stefantquach/keyboard_eval/keyboard_eval/pdf_sch/keyboard_eval.pdf

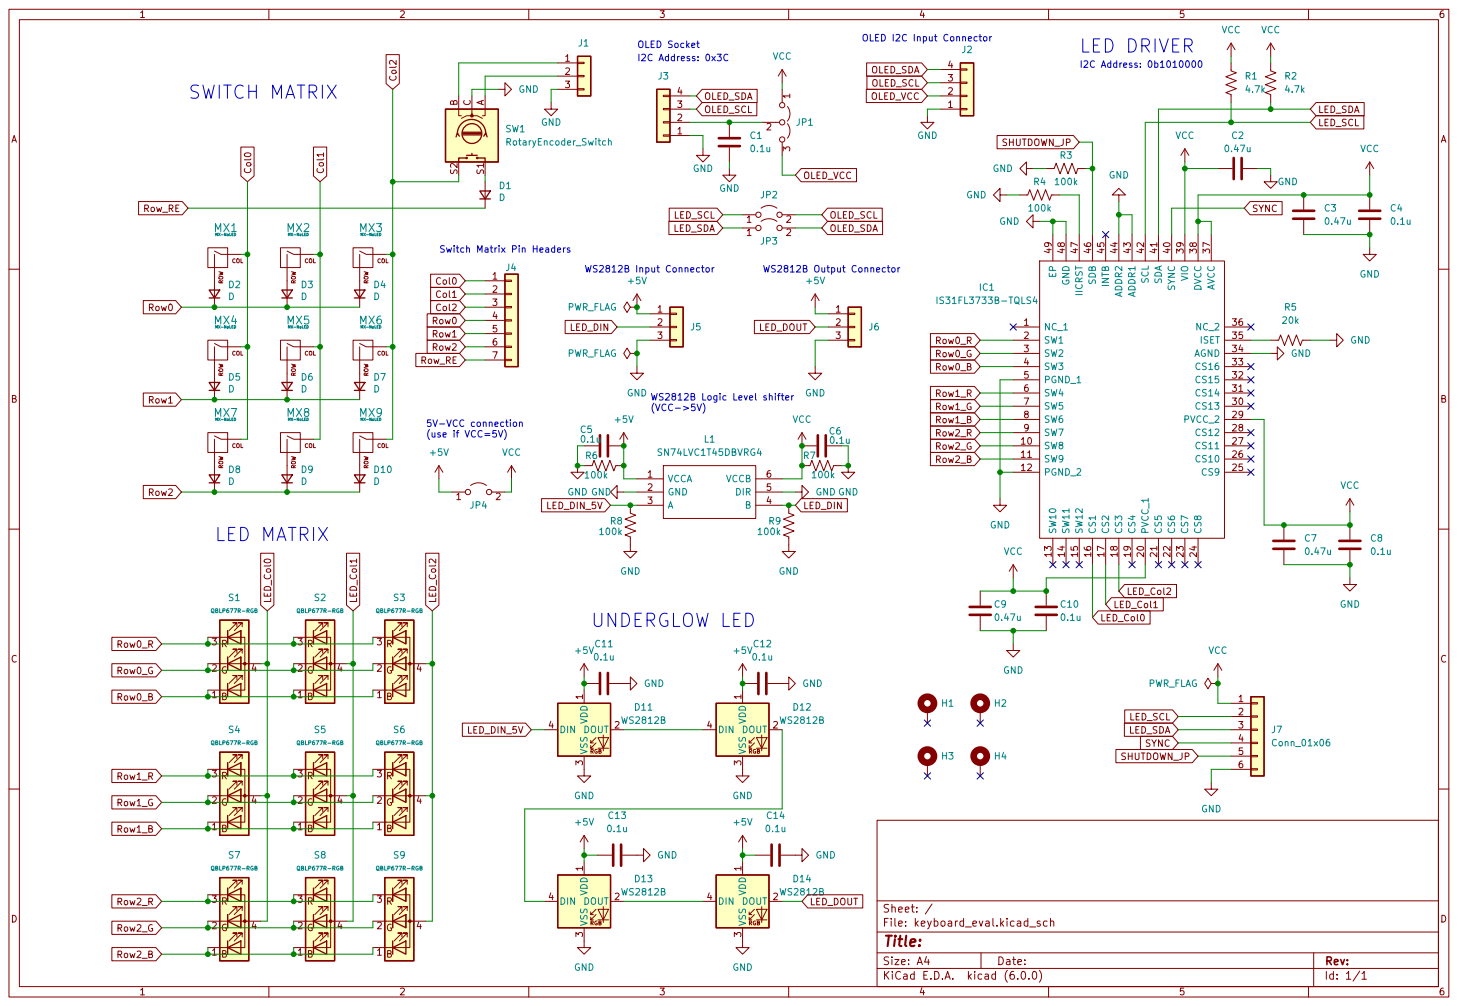
[picture p1: page 1]

COL ROW MX8 MX-NoLED BG

COL ROW MX6 MX-NoLED D6 D
