stefantquach/keyboard_eval/keyboard_eval/keyboard_eval.kicad_pcb

## KiCad design keyboard_eval/keyboard_eval.kicad_pcb (2023-01-22)

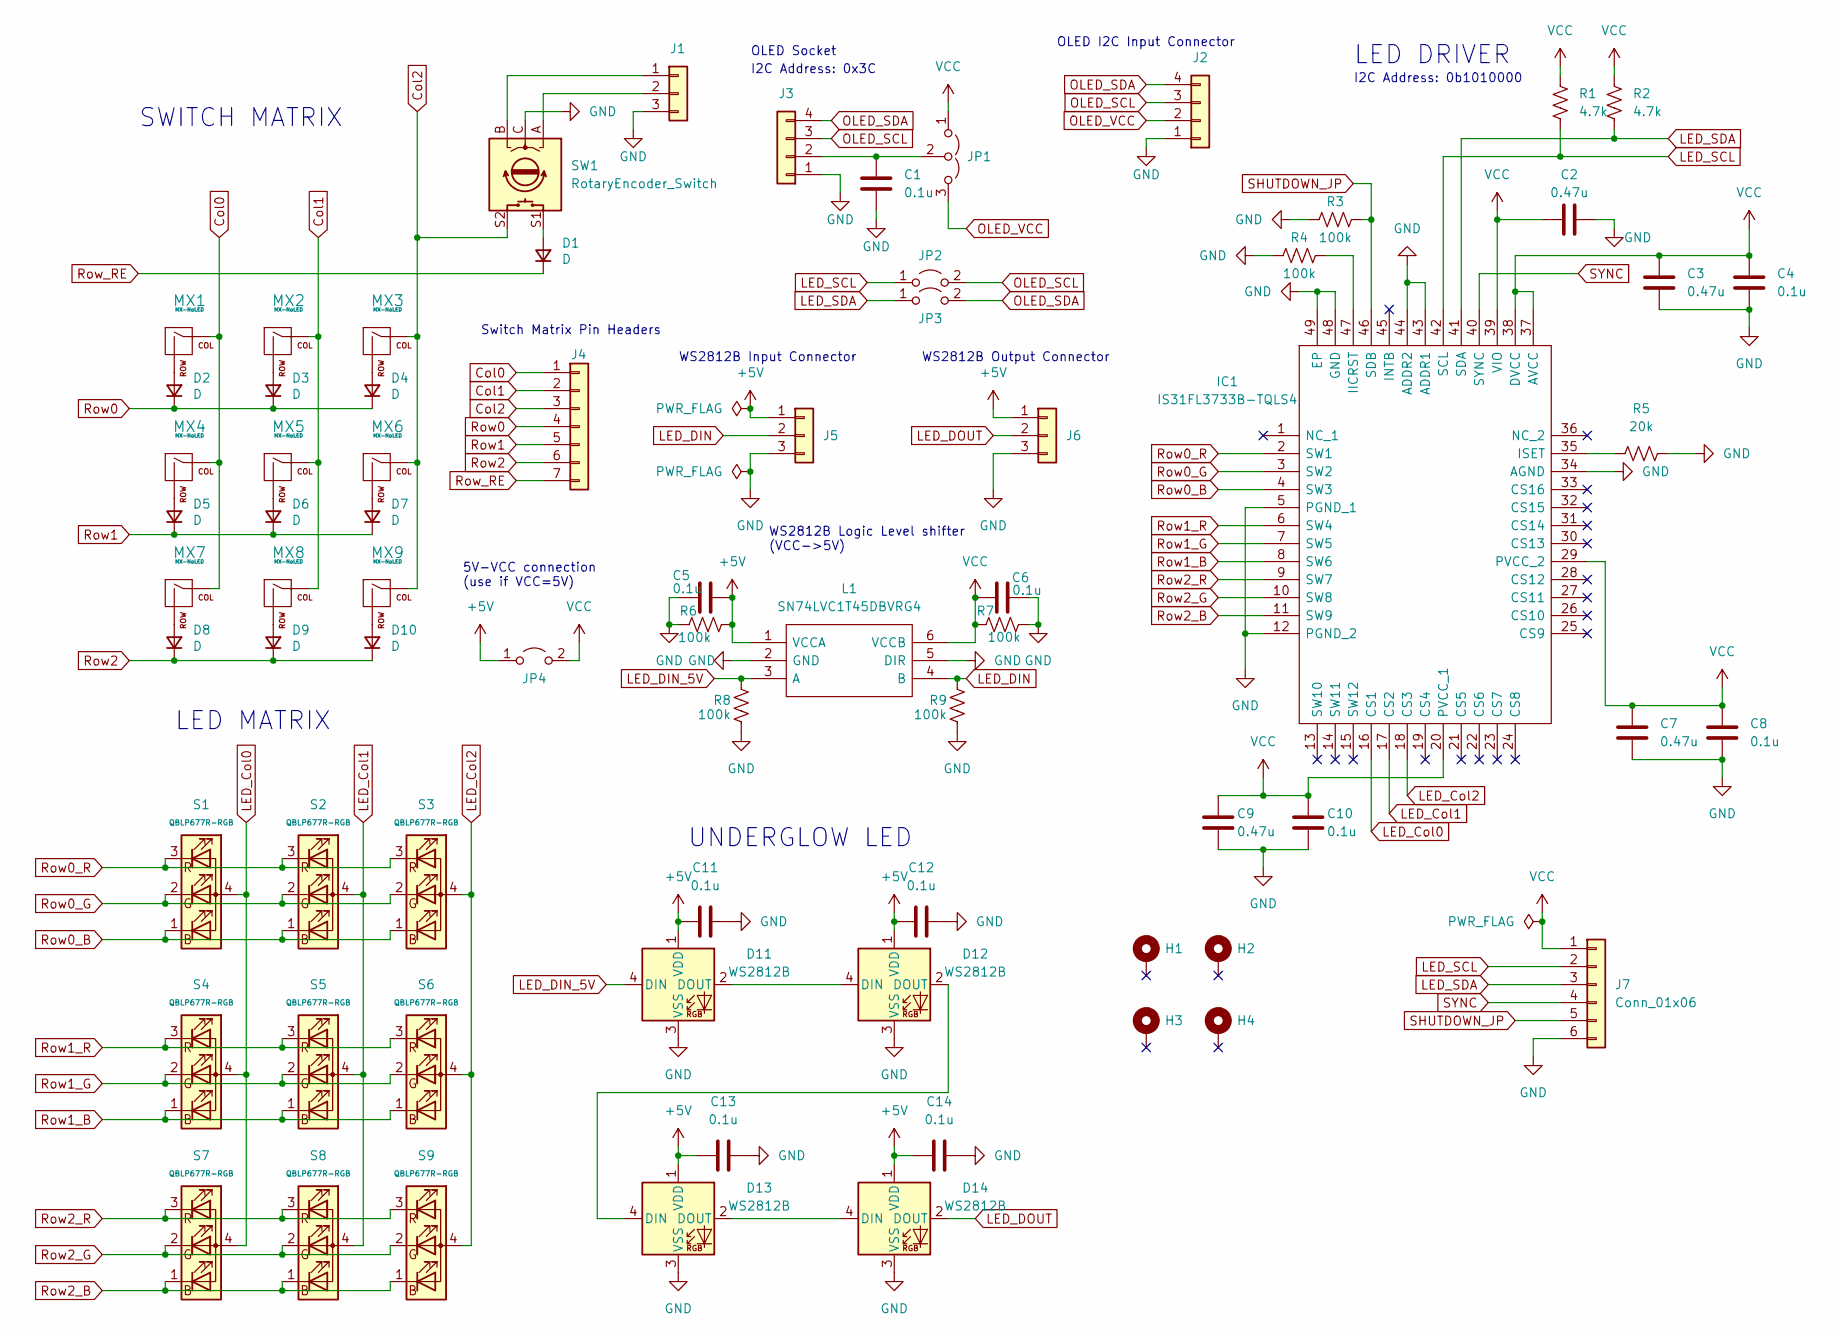
[picture p2: schematic keyboard_eval.kicad_sch]

Parts:
C1, C4, C5, C6, C8, C10, C11, C12, C13, C14: 0.1u; C_0603_1608Metric_Pad1.08x0.95mm_HandSolder
C2, C3, C7, C9: 0.47u; C_0603_1608Metric_Pad1.08x0.95mm_HandSolder
D1, D2, D3, D4, D5, D6, D7, D8, D9, D10: D; D_SOD-123-Pretty
D11, D12, D13, D14: WS2812B; LED_WS2812B_PLCC4_5.0x5.0mm_P3.2mm
H1, H2, H3, H4: MountingHole_Pad; MountingHole_2.2mm_M2_DIN965_Pad_TopBottom
IC1: IS31FL3733B-TQLS4; QFP50P900X900X120-49N; Manufacturer_Part_Number IS31FL3733B-TQLS4; Mouser Part Number 870-IS313733B-TQLS4
J1, J5, J6: Conn_01x03; PinHeader_1x03_P2.54mm_Vertical
J2, J3: Conn_01x04; PinHeader_1x04_P2.54mm_Vertical
J4: Conn_01x07; PinHeader_1x07_P2.54mm_Vertical
J7: Conn_01x06; PinHeader_1x06_P2.54mm_Vertical
JP1: Jumper_3_Open; SolderJumper-3_P1.3mm_Open_RoundedPad1.0x1.5mm
JP2, JP3, JP4: Jumper_2_Open; SolderJumper-2_P1.3mm_Open_RoundedPad1.0x1.5mm
L1: SN74LVC1T45DBVRG4; SOT95P280X145-6N; Manufacturer_Part_Number SN74LVC1T45DBVRG4; Mouser Part Number 595-74LVC1T45DBVRG4
MX1, MX2, MX3, MX4, MX5, MX6, MX7, MX8, MX9: MX-NoLED; MX-Hotswap-1U
R1, R2: 4.7k; R_0603_1608Metric_Pad0.98x0.95mm_HandSolder
R3, R4, R6, R7, R8, R9: 100k; R_0603_1608Metric_Pad0.98x0.95mm_HandSolder
R5: 20k; R_0603_1608Metric_Pad0.98x0.95mm_HandSolder
S1, S2, S3, S4, S5, S6, S7, S8, S9: QBLP677R-RGB; QBLP677R-RGB-square_cutout
SW1: RotaryEncoder_Switch; RotaryEncoder_Alps_EC11E-Switch-Vertical-EDIT

Connections:
+5V: C5.2, C11.1, C12.1, C13.1, C14.1, D11.1 (VDD), D12.1 (VDD), D13.1 (VDD), D14.1 (VDD), J5.1, J6.1, JP4.1 (A), L1.1 (VCCA), R6.1
Col0: J4.1, MX1.1 (COL), MX4.1 (COL), MX7.1 (COL)
Col1: J4.2, MX2.1 (COL), MX5.1 (COL), MX8.1 (COL)
Col2: J4.3, MX3.1 (COL), MX6.1 (COL), MX9.1 (COL), SW1.S2
GND: C1.2, C2.2, C3.2, C4.2, C5.1, C6.2, C7.2, C8.2, C9.2, C10.2, C11.2, C12.2, C13.2, C14.2, D11.3 (VSS), D12.3 (VSS), D13.3 (VSS), D14.3 (VSS), IC1.5 (PGND_1), IC1.12 (PGND_2), IC1.34 (AGND), IC1.43 (ADDR1), IC1.44 (ADDR2), IC1.48 (GND), IC1.49 (EP), J1.3, J2.1, J3.1, J5.3, J6.3, J7.6, L1.2 (GND), L1.5 (DIR), R3.1, R4.1, R5.2, R6.2, R7.1, R8.1, R9.1, SW1.C
LED_Col0: IC1.16 (CS1), S1.4 (A), S4.4 (A), S7.4 (A)
LED_Col1: IC1.17 (CS2), S2.4 (A), S5.4 (A), S8.4 (A)
LED_Col2: IC1.18 (CS3), S3.4 (A), S6.4 (A), S9.4 (A)
LED_DIN: J5.2, L1.4 (B), R9.2
LED_DIN_5V: D11.4 (DIN), L1.3 (A), R8.2
LED_DOUT: D14.2 (DOUT), J6.2
LED_SCL: IC1.42 (SCL), J7.2, JP2.1 (A), R1.2
LED_SDA: IC1.41 (SDA), J7.3, JP3.1 (A), R2.2
unnamed: C1.1, J3.2, JP1.2 (C)
unnamed: D1.2 (A), SW1.S1
unnamed: D2.2 (A), MX1.2 (ROW)
unnamed: D3.2 (A), MX2.2 (ROW)
unnamed: D4.2 (A), MX3.2 (ROW)
unnamed: D5.2 (A), MX4.2 (ROW)
unnamed: D6.2 (A), MX5.2 (ROW)
unnamed: D7.2 (A), MX6.2 (ROW)
unnamed: D8.2 (A), MX7.2 (ROW)
unnamed: D9.2 (A), MX8.2 (ROW)
unnamed: D10.2 (A), MX9.2 (ROW)
unnamed: D11.2 (DOUT), D12.4 (DIN)
unnamed: D12.2 (DOUT), D13.4 (DIN)
unnamed: D13.2 (DOUT), D14.4 (DIN)
unnamed: IC1.35 (ISET), R5.1
unnamed: IC1.47 (IICRST), R4.2
unnamed: J1.1, SW1.B
unnamed: J1.2, SW1.A
OLED_SCL: J2.3, J3.3, JP2.2 (B)
OLED_SDA: J2.4, J3.4, JP3.2 (B)
OLED_VCC: J2.2, JP1.3 (B)
Row0: D2.1 (K), D3.1 (K), D4.1 (K), J4.4
Row0_B: IC1.4 (SW3), S1.1 (BK), S2.1 (BK), S3.1 (BK)
Row0_G: IC1.3 (SW2), S1.2 (GK), S2.2 (GK), S3.2 (GK)
Row0_R: IC1.2 (SW1), S1.3 (RK), S2.3 (RK), S3.3 (RK)
Row1: D5.1 (K), D6.1 (K), D7.1 (K), J4.5
Row1_B: IC1.8 (SW6), S4.1 (BK), S5.1 (BK), S6.1 (BK)
Row1_G: IC1.7 (SW5), S4.2 (GK), S5.2 (GK), S6.2 (GK)
Row1_R: IC1.6 (SW4), S4.3 (RK), S5.3 (RK), S6.3 (RK)
Row2: D8.1 (K), D9.1 (K), D10.1 (K), J4.6
Row2_B: IC1.11 (SW9), S7.1 (BK), S8.1 (BK), S9.1 (BK)
Row2_G: IC1.10 (SW8), S7.2 (GK), S8.2 (GK), S9.2 (GK)
Row2_R: IC1.9 (SW7), S7.3 (RK), S8.3 (RK), S9.3 (RK)
Row_RE: D1.1 (K), J4.7
SHUTDOWN_JP: IC1.46 (SDB), J7.5, R3.2
SYNC: IC1.40 (SYNC), J7.4
VCC: C2.1, C3.1, C4.1, C6.1, C7.1, C8.1, C9.1, C10.1, IC1.20 (PVCC_1), IC1.29 (PVCC_2), IC1.37 (AVCC), IC1.38 (DVCC), IC1.39 (VIO), J7.1, JP1.1 (A), JP4.2 (B), L1.6 (VCCB), R1.1, R2.1, R7.2

Notes on the sheet:
OLED I2C Input Connector
I2C Address: 0x3C
UNDERGLOW LED
LED DRIVER
5V-VCC connection (use if VCC=5V)
WS2812B Output Connector
I2C Address: 0b1010000
WS2812B Logic Level shifter (VCC->5V)
SWITCH MATRIX
WS2812B Input Connector
OLED Socket
LED MATRIX
Switch Matrix Pin Headers

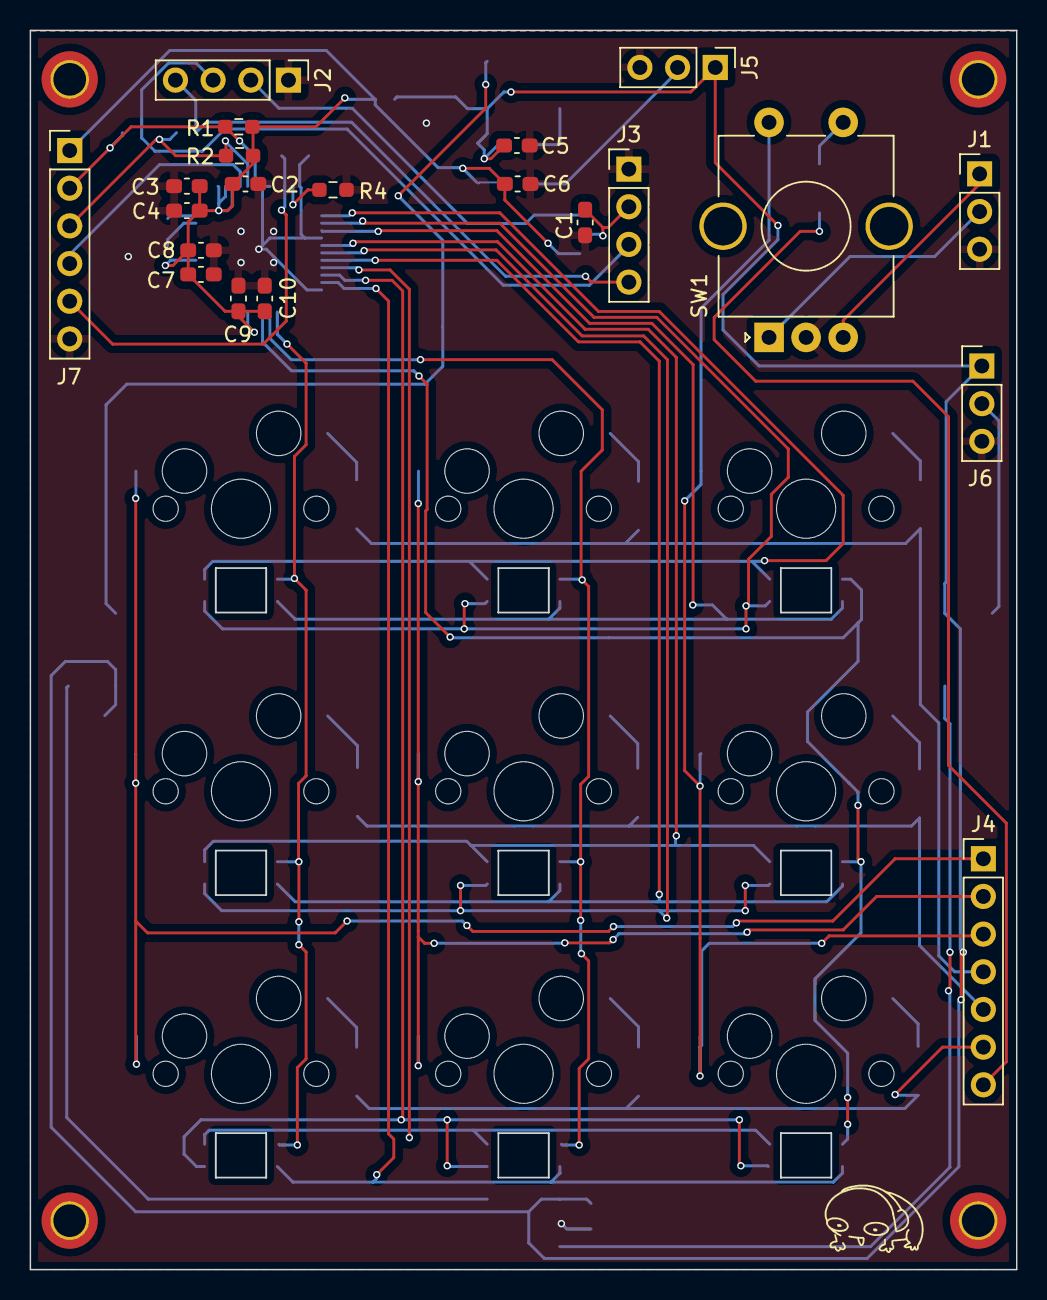
[picture p3: board keyboard_eval.kicad_pcb from above]

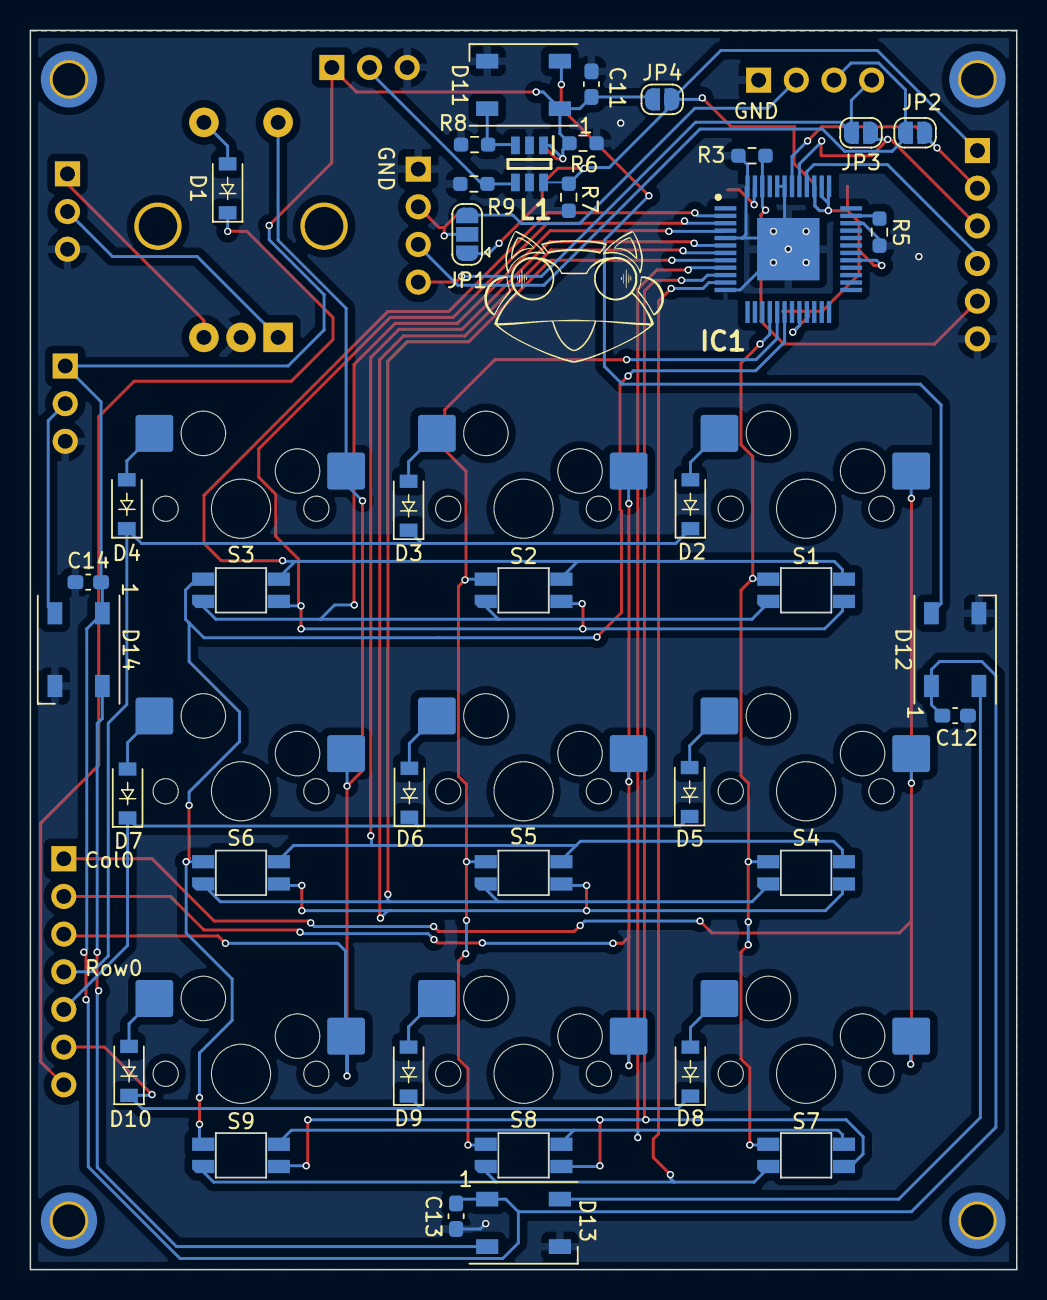
[picture p4: board keyboard_eval.kicad_pcb from below]

Board: 2 copper layers, 66.5 x 83.5 mm, 73 parts (39 on the bottom side), 50 nets.
