stefantquach/keyboard_eval/firmware/config.h

// Copyright 2023 Stefan Quach (@Stefan Quach)
// SPDX-License-Identifier: GPL-2.0-or-later

#pragma once

/*
 * Feature disable options
 *  These options are also useful to firmware size reduction.
 */

/* disable debug print */
//#define NO_DEBUG

/* disable print */
//#define NO_PRINT

/* disable action features */
//#define NO_ACTION_LAYER
//#define NO_ACTION_TAPPING
//#define NO_ACTION_ONESHOT

/*
 * Keyboard Matrix Assignments
 *
 * Change this to how you wired your keyboard
 * COLS: AVR pins used for columns, left to right
 * ROWS: AVR pins used for rows, top to bottom
 * DIODE_DIRECTION: COL2ROW = COL = Anode (+), ROW = Cathode (-, marked on diode)
 *                  ROW2COL = ROW = Anode (+), COL = Cathode (-, marked on diode)
 *
 */
/* key matrix size */
#define MATRIX_ROWS 4
#define MATRIX_COLS 3

#define MATRIX_ROW_PINS { F5, B1, F7, F6 } 
#define MATRIX_COL_PINS { B6, B2, B3 }

/* COL2ROW, ROW2COL */
#define DIODE_DIRECTION COL2ROW

/* Debounce reduces chatter (unintended double-presses) - set 0 if debouncing is not needed */
#define DEBOUNCE 5

/* 
 * RGB Matrix 
 * 
 * This is the per-key RGB lighting driven by the IS31FL3733(B)
 * 
 * */
#define DRIVER_COUNT 1
#define DRIVER_ADDR_1 0b1010000

#define RGB_MATRIX_LED_COUNT 27 // 9 LEDS * 3 RGB

#define ISSI_PWM_FREQUENCY 0
#define ISSI_GLOBALCURRENT 0xFF

#define RGB_MATRIX_DEFAULT_VAL 80
#define RGB_MATRIX_FRAMEBUFFER_EFFECTS
#define RGB_MATRIX_KEYPRESSES
#define RGB_DISABLE_WHEN_USB_SUSPENDED  // turn off effects when suspended
#define RGB_MATRIX_DEFAULT_MODE RGB_MATRIX_HUE_WAVE

#define ENABLE_RGB_MATRIX_ALPHAS_MODS
#define ENABLE_RGB_MATRIX_GRADIENT_UP_DOWN
#define ENABLE_RGB_MATRIX_GRADIENT_LEFT_RIGHT
#define ENABLE_RGB_MATRIX_BREATHING
// #define ENABLE_RGB_MATRIX_BAND_SAT
// #define ENABLE_RGB_MATRIX_BAND_VAL
// #define ENABLE_RGB_MATRIX_BAND_PINWHEEL_SAT
// #define ENABLE_RGB_MATRIX_BAND_PINWHEEL_VAL
// #define ENABLE_RGB_MATRIX_BAND_SPIRAL_SAT
// #define ENABLE_RGB_MATRIX_BAND_SPIRAL_VAL
// #define ENABLE_RGB_MATRIX_CYCLE_ALL
// #define ENABLE_RGB_MATRIX_CYCLE_LEFT_RIGHT
// #define ENABLE_RGB_MATRIX_CYCLE_UP_DOWN
// #define ENABLE_RGB_MATRIX_RAINBOW_MOVING_CHEVRON
// #define ENABLE_RGB_MATRIX_CYCLE_OUT_IN
// #define ENABLE_RGB_MATRIX_CYCLE_OUT_IN_DUAL
// #define ENABLE_RGB_MATRIX_CYCLE_PINWHEEL
// #define ENABLE_RGB_MATRIX_CYCLE_SPIRAL
// #define ENABLE_RGB_MATRIX_DUAL_BEACON
// #define ENABLE_RGB_MATRIX_RAINBOW_BEACON
// #define ENABLE_RGB_MATRIX_RAINBOW_PINWHEELS
// #define ENABLE_RGB_MATRIX_RAINDROPS
// #define ENABLE_RGB_MATRIX_JELLYBEAN_RAINDROPS
// #define ENABLE_RGB_MATRIX_HUE_BREATHING
// #define ENABLE_RGB_MATRIX_HUE_PENDULUM
#define ENABLE_RGB_MATRIX_HUE_WAVE
// #define ENABLE_RGB_MATRIX_FRACTAL
// #define ENABLE_RGB_MATRIX_PIXEL_RAIN

#define ENABLE_RGB_MATRIX_TYPING_HEATMAP
#define ENABLE_RGB_MATRIX_DIGITAL_RAIN

#define ENABLE_RGB_MATRIX_SOLID_REACTIVE_SIMPLE
// #define ENABLE_RGB_MATRIX_SOLID_REACTIVE
// #define ENABLE_RGB_MATRIX_SOLID_REACTIVE_WIDE
// #define ENABLE_RGB_MATRIX_SOLID_REACTIVE_MULTIWIDE
// #define ENABLE_RGB_MATRIX_SOLID_REACTIVE_CROSS
// #define ENABLE_RGB_MATRIX_SOLID_REACTIVE_MULTICROSS
// #define ENABLE_RGB_MATRIX_SOLID_REACTIVE_NEXUS
// #define ENABLE_RGB_MATRIX_SOLID_REACTIVE_MULTINEXUS
#define ENABLE_RGB_MATRIX_SPLASH
// #define ENABLE_RGB_MATRIX_MULTISPLASH
// #define ENABLE_RGB_MATRIX_SOLID_SPLASH
// #define ENABLE_RGB_MATRIX_SOLID_MULTISPLASH


/* 
 * RGB Lighting
 * 
 * This is the underglow lighting driven by ws2812B addressable LEDs
 * 
 */
#define RGB_DI_PIN E6
#define RGBLED_NUM 4
#define RGBLIGHT_LED_MAP { 0, 1, 2, 3 }

/* 
 * Encoder configuration
 * 
 */
#define ENCODERS_PAD_A { B4 }
#define ENCODERS_PAD_B { B5 }

/* 
 * OLED configuration
 * 
 */
#define OLED_DISPLAY_ADDRESS 0x3C
#define OLED_BRIGHTNESS 128
#define OLED_IC OLED_IC_SSD1306

#define OLED_DISPLAY_WIDTH 128
#define OLED_DISPLAY_HEIGHT 32
