stefantquach/keyboard_eval/firmware/keymaps/default/keymap.c

#include QMK_KEYBOARD_H

enum my_keycodes {
    WPM = SAFE_RANGE,
};

#define _BASE 0
#define _HUE 1
#define _VAL 2
#define _MOD 3
const uint16_t PROGMEM keymaps[][MATRIX_ROWS][MATRIX_COLS] = {
    /*
     * ┌───┬───┬───┐
     * │ A │ B │ C │
     * ├───┼───┼───┤
     * │ D │ E │ F │
     * ├───┼───┼───┤
     * │ G │ H │ I │
     * └───┴───┴───┘
     */
    [_BASE] = LAYOUT(
                          KC_MPLY, \
        KC_A,    KC_B,    KC_C, \
        KC_D,    KC_E,    KC_F, \
        MO(_HUE),  MO(_VAL),  MO(_MOD)  
    ),

    [_HUE] = LAYOUT(
                                 _______ , \
        _______ ,    _______ ,    _______ , \
        _______ ,    _______ ,    _______ , \
        MO(_HUE),  MO(_VAL),  MO(_MOD)  
    ),

    [_VAL] = LAYOUT(
                        _______ , \
    _______ ,    _______ ,    _______ , \
    _______ ,    _______ ,    _______ , \
    MO(_HUE),  MO(_VAL),  MO(_MOD)  
    ),

    [_MOD] = LAYOUT(
                            RGB_TOG , \
    _______ ,    _______ ,    _______ , \
    _______ ,    _______ ,    _______ , \
    MO(_HUE),  MO(_VAL),  MO(_MOD)  
    ),
};


/* WPM toggle key bongocat hehe */
bool wpm = false;
bool process_record_user(uint16_t keycode, keyrecord_t *record) {
  switch (keycode) {
    case WPM:
        if (record->event.pressed) {
            wpm = !wpm;
        }
        return false;
    default:
        return true;
  }
}
/*layer switcher */
layer_state_t layer_state_set_user(layer_state_t state) {
    state = update_tri_layer_state(state, _HUE, _VAL, _MOD);
    return state;
}

#if defined(ENCODER_MAP_ENABLE)
const uint16_t PROGMEM encoder_map[][NUM_ENCODERS][2] = {
    [_BASE] = { ENCODER_CCW_CW(KC_VOLU, KC_VOLD) },
    [_HUE] =  { ENCODER_CCW_CW(RGB_HUD, RGB_HUI) },
    [_VAL] =  { ENCODER_CCW_CW(RGB_VAD, RGB_VAI) },
    [_MOD] =  { ENCODER_CCW_CW(RGB_RMOD, RGB_MOD) },
};
#endif


#ifdef OLED_ENABLE
#define IDLE_FRAMES 5
#define IDLE_SPEED 20 // below this wpm value your animation will idle
#define TAP_FRAMES 2
#define TAP_SPEED 40 // above this wpm value typing animation to trigger
#define ANIM_FRAME_DURATION 200 // how long each frame lasts in ms
#define ANIM_SIZE 636 // number of bytes in array

uint32_t anim_timer         = 0;
uint32_t anim_sleep         = 0;
uint8_t  current_idle_frame = 0;
uint8_t current_tap_frame = 0;

uint16_t startup_timer = 0;

oled_rotation_t oled_init_user(oled_rotation_t rotation) {
    startup_timer = timer_read();
    return rotation;
}
static void render_logo(void) {
    // static const char PROGMEM raw_logo[] = {
    //     0,  8,  0,192,194,192,192, 60, 60, 44, 60,188, 60, 60, 60, 60, 44, 61, 60,192,192,192,208,  1,  0,252,252,180,252, 60, 60, 44, 60,252,253,252,252, 60, 60, 44, 60,244,220,252,252,  0,  0, 16,  0,  0,  0,192,192, 65,192, 60, 60, 52, 60,192,193,192,192, 16,  0,  0,144,  4,  0,252,125,244, 60, 60, 60, 60, 61,252,252,244,252, 60, 60, 60, 61,248,108,252,  0,  0, 61, 60,188, 60, 52,252,252,220,252, 61, 60, 60, 52,  0,  0,192,210, 64,192, 60, 60, 44, 61, 60, 60, 60, 61, 52, 60, 60, 60,192,192, 64,196,  0,  4,  0,
    //     0, 16,  0, 61, 63, 55, 63,192, 64,192,196,192,192,192,200,192,196,192,192,  3,  3,  2, 11,  0,  0, 35,  3,  3,  3,  0, 64,  2,  0,255,255,253,247,  0,  0,  0, 32,  1,  0,  1, 65,  8,  0,189,244,252,236,  3,130,  3,  1,  0, 68,  0,  0,  3, 34,131,  3,252,252,236,252,  0, 32, 17,  1,  1,  0,  0, 32,  0,  2,255,255,127,247,  0,  1,  0,  8,  1,  1,  1,  0,  0,  0, 16,  0, 64,  0,255,191,255,251,  0,129,  0,  2, 32,  0,255,255,239,255,  0,  0,  2,  0,  0,  0,  8, 64,  0,  1,  0,  0,  3, 35,  3,  3,  0,  8,  0,
    //     1, 16,  0,192, 64,194,192,  3, 67,  3,  3,  9,  3,  3,  3,  3,  2, 83,  3,252,252,188,244,  0,  2, 32,  0,  0,  2,  0,144,  0,  0,255,255,237,255,  0, 16,  0,  0,  0, 64,  2,  0,128,  0,255,123,255,255, 60, 52, 60, 60, 60, 60, 60, 60, 44, 60, 56, 60,239,255,126,255,  0,  2, 32,  0,  0, 34,  0,  0, 16,  0,255,255,255,223,  0,  0,  4,  0,  0,  0, 33,  0,  0, 17,  0,  0,  0,  0,255,255,239,255,  0,128,  0,  0, 72,  0,255,253,247,255,  0,  0,  1,  0,144,  0,  4,  0, 32,  0,  0,  2,192,192,192,200,  0, 16,  0,
    //     64,  4,  0,  3,  7,  3,  3, 60, 60, 52,188, 60, 61, 60, 60, 60, 60, 44, 60, 67,  3,  3,  3,  0,  0, 64,  0,  0,  4,  0,  0, 16,  0, 47, 63, 62, 63,  0,  0,132,  0,  0,  0,  0,128,  8,  0,255,255,111,127,  0,  0,  0,  2,128,  0,  0,  0, 64,  4,  0,128,127,127,107,127,  0, 32,  0,  0,  0, 66,  0,  0,  0,136, 55, 63, 61, 63,  0,  0,  0,  2,  0, 64,  0,136,  0,  0, 60, 44,189, 60, 63, 63, 63, 59, 60, 60,172, 60,  0, 64,  3,  2,  3,131, 60, 44, 60, 60, 60, 60,188, 60, 56, 44, 60, 60,  3,  3,131,  2,  0, 32,  2,
    // };
    // oled_write_raw_P(raw_logo, sizeof(raw_logo));
    static const char PROGMEM qmk_logo[] = {
        0x80, 0x81, 0x82, 0x83, 0x84, 0x85, 0x86, 0x87, 0x88, 0x89, 0x8A, 0x8B, 0x8C, 0x8D, 0x8E, 0x8F, 0x90, 0x91, 0x92, 0x93, 0x94,
        0xA0, 0xA1, 0xA2, 0xA3, 0xA4, 0xA5, 0xA6, 0xA7, 0xA8, 0xA9, 0xAA, 0xAB, 0xAC, 0xAD, 0xAE, 0xAF, 0xB0, 0xB1, 0xB2, 0xB3, 0xB4,
        0xC0, 0xC1, 0xC2, 0xC3, 0xC4, 0xC5, 0xC6, 0xC7, 0xC8, 0xC9, 0xCA, 0xCB, 0xCC, 0xCD, 0xCE, 0xCF, 0xD0, 0xD1, 0xD2, 0xD3, 0xD4, 0x00
    };

    oled_write_P(qmk_logo, false);
}
/* Shows the name of the current layer and locks for the host (CAPS etc.) */
// static void render_layer(void) {
//     led_t led_state = host_keyboard_led_state();
//     // clang-format off
//     static const char PROGMEM logo[][3][7] = {
//         {{0x97, 0x98, 0x99, 0x9A, 0}, {0x91, 0x92, 0x93, 0x94, 0x95, 0x96, 0}, {0x9B, 0x9C, 0x9D, 0x9E, 0x9F, 0}}, /* l      num      CB */
//         {{0xB7, 0xB8, 0xB9, 0xBA, 0}, {0xB1, 0xB2, 0xB3, 0xB4, 0xB5, 0xB6, 0}, {0xBB, 0xBC, 0xBD, 0xBE, 0xBF, 0}}, /* 1      num      CB */
//         {{0xD7, 0xD8, 0xD9, 0xDA, 0}, {0xD1, 0xD2, 0xD3, 0xD4, 0xD5, 0xD6, 0}, {0xDB, 0xDC, 0xDD, 0xDE, 0xDF, 0}}, /* 1      cap      CB */
//         {{0xF7, 0xF8, 0xF9, 0xFA, 0}, {0xF1, 0xF2, 0xF3, 0xF4, 0xF5, 0xF6, 0}, {0xFB, 0xFC, 0xFD, 0xFE, 0xFF, 0}}, /* l      cap      CB */
//         {{0xB7, 0xC0, 0xC1, 0xBA, 0}, {0xB7, 0xC2, 0xC3, 0xBA, 0},             {0xB7, 0xC4, 0xC5, 0xBA, 0}},       /* 2       3       4  */
//         {{0xD7, 0xE0, 0xE1, 0xDA, 0}, {0xD7, 0xE2, 0xE3, 0xDA, 0},             {0xD7, 0xE4, 0xE5, 0xDA, 0}},       /* 2       3       4  */
//     };
//     // clang-format on
//     oled_set_cursor(0, 0);
//     oled_write_P(logo[0][0], false);
//     oled_set_cursor(0, 3);
//     oled_write_P(logo[3][0], false);
//     switch (get_highest_layer(layer_state)) {
//         case _BASE:
//             oled_set_cursor(0, 1);
//             oled_write_P(logo[1][0], false);
//             oled_set_cursor(0, 2);
//             oled_write_P(logo[2][0], false);
//             break;
//         case _HUE:
//             oled_set_cursor(0, 1);
//             oled_write_P(logo[4][0], false);
//             oled_set_cursor(0, 2);
//             oled_write_P(logo[5][0], false);
//             break;
//         case _VAL:
//             oled_set_cursor(0, 1);
//             oled_write_P(logo[4][1], false);
//             oled_set_cursor(0, 2);
//             oled_write_P(logo[5][1], false);
//             break;
//         case _MOD:
//             oled_set_cursor(0, 1);
//             oled_write_P(logo[4][2], false);
//             oled_set_cursor(0, 2);
//             oled_write_P(logo[5][2], false);
//             break;
//         default:
//             oled_set_cursor(0, 1);
//             oled_write_P(PSTR("    "), false);
//             oled_set_cursor(0, 2);
//             oled_write_P(PSTR("    "), false);
//     }
//     oled_set_cursor(8, 0);
//     oled_write_P(led_state.num_lock ? logo[0][1] : PSTR("      "), false);
//     oled_set_cursor(8, 1);
//     oled_write_P(led_state.num_lock ? logo[1][1] : PSTR("      "), false);
//     oled_set_cursor(8, 2);
//     oled_write_P(led_state.caps_lock ? logo[2][1] : PSTR("      "), false);
//     oled_set_cursor(8, 3);
//     oled_write_P(led_state.caps_lock ? logo[3][1] : PSTR("      "), false);

//     oled_set_cursor(16, 0);
//     oled_write_P(logo[0][2], false);
//     oled_set_cursor(16, 1);
//     oled_write_P(logo[1][2], false);
//     oled_set_cursor(16, 2);
//     oled_write_P(logo[2][2], false);
//     oled_set_cursor(16, 3);
//     oled_write_P(logo[3][2], false);

//     /* Fill empty space to clear animation */
//     oled_set_cursor(4, 0);
//     oled_write_P(PSTR("    "), false);
//     oled_set_cursor(4, 1);
//     oled_write_P(PSTR("    "), false);
//     oled_set_cursor(4, 2);
//     oled_write_P(PSTR("    "), false);
//     oled_set_cursor(4, 3);
//     oled_write_P(PSTR("    "), false);

//     oled_set_cursor(14, 0);
//     oled_write_P(PSTR("  "), false);
//     oled_set_cursor(14, 1);
//     oled_write_P(PSTR("  "), false);
//     oled_set_cursor(14, 2);
//     oled_write_P(PSTR("  "), false);
//     oled_set_cursor(14, 3);
//     oled_write_P(PSTR("  "), false);
// }

// static void render_cat(void) {
//     static const char PROGMEM idle[IDLE_FRAMES][ANIM_SIZE] = {
//         {0x00, 0x00, 0x00, 0x00, 0x00, 0x00, 0x00, 0x00, 0x00, 0x00, 0x00, 0x00, 0x00, 0x00, 0x00, 0x00, 0x00, 0x00, 0x00, 0x00, 0x00, 0x00, 0x00, 0x00, 0x00, 0x00, 0x00, 0x00, 0x00, 0x00, 0x00, 0x00, 0x00, 0x00, 0x00, 0x00, 0x00, 0x00, 0x00, 0x00, 0x00, 0x00, 0x00, 0x00, 0x00, 0x00, 0x00, 0x00, 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
//         {0x00, 0x00, 0x00, 0x00, 0x00, 0x00, 0x00, 0x00, 0x00, 0x00, 0x00, 0x00, 0x00, 0x00, 0x00, 0x00, 0x00, 0x00, 0x00, 0x00, 0x00, 0x00, 0x00, 0x00, 0x00, 0x00, 0x00, 0x00, 0x00, 0x00, 0x00, 0x00, 0x00, 0x00, 0x00, 0x00, 0x00, 0x00, 0x00, 0x00, 0x00, 0x00, 0x00, 0x00, 0x00, 0x00, 0x00, 0x00, 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
//         {0x00, 0x00, 0x00, 0x00, 0x00, 0x00, 0x00, 0x00, 0x00, 0x00, 0x00, 0x00, 0x00, 0x00, 0x00, 0x00, 0x00, 0x00, 0x00, 0x00, 0x00, 0x00, 0x00, 0x00, 0x00, 0x00, 0x00, 0x00, 0x00, 0x00, 0x00, 0x00, 0x00, 0x00, 0x00, 0x00, 0x00, 0x00, 0x00, 0x00, 0x00, 0x00, 0x00, 0x00, 0x00, 0x00, 0x00, 0x00, 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
//         {0x00, 0x00, 0x00, 0x00, 0x00, 0x00, 0x00, 0x00, 0x00, 0x00, 0x00, 0x00, 0x00, 0x00, 0x00, 0x00, 0x00, 0x00, 0x00, 0x00, 0x00, 0x00, 0x00, 0x00, 0x00, 0x00, 0x00, 0x00, 0x00, 0x00, 0x00, 0x00, 0x00, 0x00, 0x00, 0x00, 0x00, 0x00, 0x00, 0x00, 0x00, 0x00, 0x00, 0x00, 0x00, 0x00, 0x00, 0x00, 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
//         {0x00, 0x00, 0x00, 0x00, 0x00, 0x00, 0x00, 0x00, 0x00, 0x00, 0x00, 0x00, 0x00, 0x00, 0x00, 0x00, 0x00, 0x00, 0x00, 0x00, 0x00, 0x00, 0x00, 0x00, 0x00, 0x00, 0x00, 0x00, 0x00, 0x00, 0x00, 0x00, 0x00, 0x00, 0x00, 0x00, 0x00, 0x00, 0x00, 0x00, 0x00, 0x00, 0x00, 0x00, 0x00, 0x00, 0x00, 0x00, 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
//     static const char PROGMEM prep[][ANIM_SIZE] = {
//         {0x00, 0x00, 0x00, 0x00, 0x00, 0x00, 0x00, 0x00, 0x00, 0x00, 0x00, 0x00, 0x00, 0x00, 0x00, 0x00, 0x00, 0x00, 0x00, 0x00, 0x00, 0x00, 0x00, 0x00, 0x00, 0x00, 0x00, 0x00, 0x00, 0x00, 0x00, 0x00, 0x00, 0x00, 0x00, 0x00, 0x00, 0x00, 0x00, 0x00, 0x00, 0x00, 0x00, 0x00, 0x00, 0x00, 0x00, 0x00, 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
//     static const char PROGMEM tap[TAP_FRAMES][ANIM_SIZE] = {
//         {0x00, 0x00, 0x00, 0x00, 0x00, 0x00, 0x00, 0x00, 0x00, 0x00, 0x00, 0x00, 0x00, 0x00, 0x00, 0x00, 0x00, 0x00, 0x00, 0x00, 0x00, 0x00, 0x00, 0x00, 0x00, 0x00, 0x00, 0x00, 0x00, 0x00, 0x00, 0x00, 0x00, 0x00, 0x00, 0x00, 0x00, 0x00, 0x00, 0x00, 0x00, 0x00, 0x00, 0x00, 0x00, 0x00, 0x00, 0x00, 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
//         {0x00, 0x00, 0x00, 0x00, 0x00, 0x00, 0x00, 0x00, 0x00, 0x00, 0x00, 0x00, 0x00, 0x00, 0x00, 0x00, 0x00, 0x00, 0x00, 0x00, 0x00, 0x00, 0x00, 0x00, 0x00, 0x00, 0x00, 0x00, 0x00, 0x00, 0x00, 0x00, 0x00, 0x00, 0x00, 0x00, 0x00, 0x00, 0x00, 0x00, 0x00, 0x00, 0x00, 0x00, 0x00, 0x00, 0x00, 0x00, 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
//     };

//     void animation_phase(void) {
//         if (get_current_wpm() <= IDLE_SPEED) {
//             current_idle_frame = (current_idle_frame + 1) % IDLE_FRAMES;
//             oled_write_raw_P(idle[abs((IDLE_FRAMES - 1) - current_idle_frame)], ANIM_SIZE);
//         }
//         if (get_current_wpm() > IDLE_SPEED && get_current_wpm() < TAP_SPEED) {
//             oled_write_raw_P(prep[0], ANIM_SIZE);
//         }
//         if (get_current_wpm() >= TAP_SPEED) {
//             current_tap_frame = (current_tap_frame + 1) % TAP_FRAMES;
//             oled_write_raw_P(tap[abs((TAP_FRAMES - 1) - current_tap_frame)], ANIM_SIZE);
//         }
//     }
//     if (get_current_wpm() != 000) {
//         if (timer_elapsed32(anim_timer) > ANIM_FRAME_DURATION) {
//             anim_timer = timer_read32();
//             animation_phase();
//         }
//         anim_sleep = timer_read32();
//     } else {
//         if (timer_elapsed32(anim_timer) > ANIM_FRAME_DURATION) {
//             anim_timer = timer_read32();
//             animation_phase();
//         }
//     }
// }

bool oled_task_user(void) {
    // static bool finished_timer = false;
    // if (!finished_timer && (timer_elapsed(startup_timer) < 3000)) {
    //     render_logo();
    // } else {
    //     if (!finished_timer) {
    //         oled_clear();
    //         finished_timer = true;
    //     }
    //     if (wpm) {
    //         render_cat();
    //         oled_set_cursor(0, 0);
    //         char string[10];
    //         uint16_t m = get_current_wpm();
    //         string[3] = '\0';
    //         string[2] = '0' + m % 10;
    //         string[1] = ( m /= 10) % 10 ? '0' + (m) % 10 : (m / 10) % 10 ? '0' : ' ';
    //         string[0] =  m / 10 ? '0' + m / 10 : ' ';
    //         oled_write_P(PSTR("WPM:"), false);
    //         oled_write(string, false);
    //     } 
    //     // else
    //     // {
    //     //     render_layer();
    //     // }
    // }
    render_logo();
    return false;
}
#endif
