stefantquach/keyboard_eval/(commit log)

2022-12-22 Initial commit of schematic and WIP layout
    [keyboard_eval.kicad_pcb, keyboard_eval.kicad_sch]
2022-12-23 WIP layout
    [keyboard_eval.kicad_pcb, keyboard_eval.kicad_sch]
2022-12-24 Finished initial layout
    [keyboard_eval.kicad_pcb, keyboard_eval.kicad_sch]
2022-12-25 Fixing RGB LED footprint. Fixing missing bits of copper fill
    [keyboard_eval.kicad_pcb]
2023-01-01 Adding gerbers and pdf schematic
    [keyboard_eval-B_Cu.gbl, keyboard_eval-B_Mask.gbs, keyboard_eval-B_Paste.gbp, keyboard_eval-B_Silkscreen.gbo, keyboard_eval-Edge_Cuts.gm1, keyboard_eval-F_Cu.gtl, keyboard_eval-F_Mask.gts, keyboard_eval-F_Paste.gtp]
2023-01-15 Adding firmware. WIP
    [keyboard_eval.csv]
2023-01-22 Fixing schematics and firmware
    [keyboard_eval.kicad_pcb, keyboard_eval.kicad_sch]
2023-01-22 Updating pdf sch and gerbers to fix layout bugs
    [keyboard_eval-B_Cu.gbl, keyboard_eval-B_Mask.gbs, keyboard_eval-B_Paste.gbp, keyboard_eval-B_Silkscreen.gbo, keyboard_eval-Edge_Cuts.gm1, keyboard_eval-F_Cu.gtl, keyboard_eval-F_Mask.gts, keyboard_eval-F_Paste.gtp]
